abzman/multi-leg-desk-controller/README.md

# multi-leg-desk-controller
esp32 controller for 4 or so legs of a standing desk
