abzman/multi-leg-desk-controller/DeskController/docs/preset_ladder.png

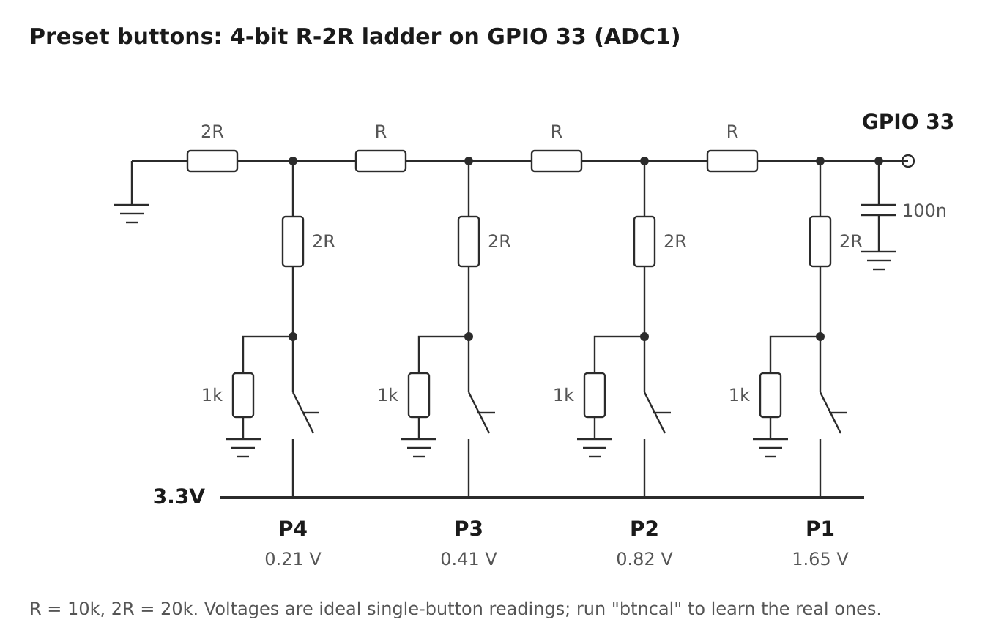
DeskController/docs/preset_ladder.png
