abzman/multi-leg-desk-controller/DeskController/docs/wiring_diagram.png

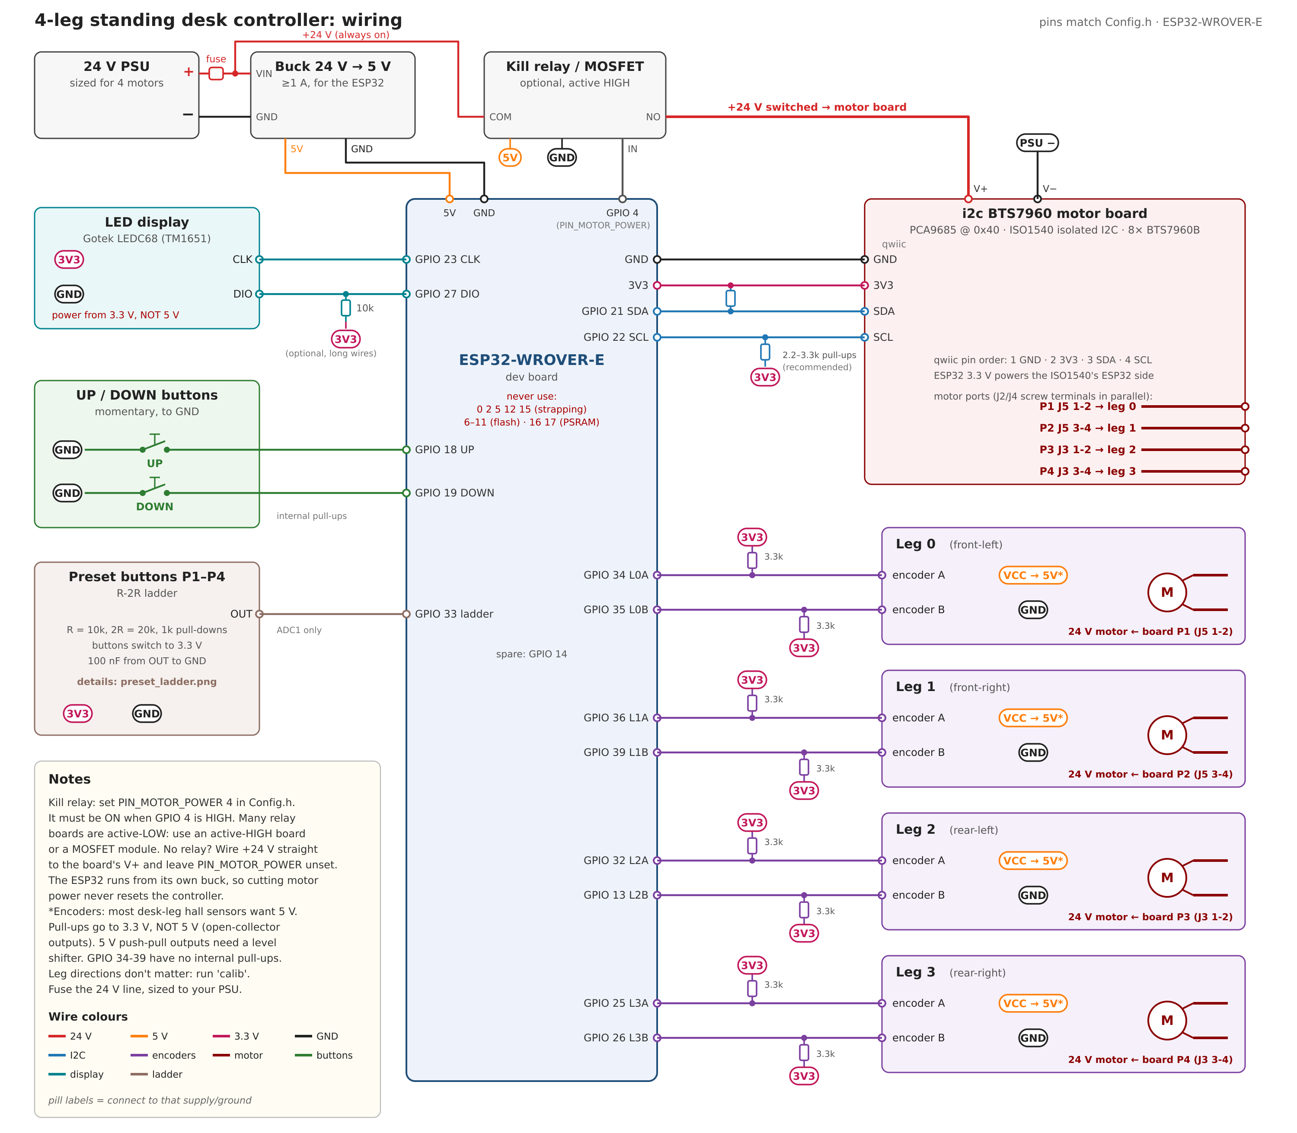
DeskController/docs/wiring_diagram.png
