abzman/multi-leg-desk-controller/DeskController/secrets.example.h

// Copy this file to secrets.h and fill it in. Keep secrets.h out of git.
#pragma once
#define WIFI_SSID      "your-wifi"
#define WIFI_PASSWORD  "your-wifi-password"

// MQTT broker. For the Home Assistant Mosquitto add-on, use your HA
// machine's IP and a Home Assistant user (or a dedicated MQTT user).
#define MQTT_URI       "mqtt://192.168.1.10:1883"
#define MQTT_USER      "desk"
#define MQTT_PASSWORD  "desk-password"
